thomaskneisel/LightRider/Inspiration.md

Inspiration
======

<h4>Quellen:</h4>
 * GPIO 12 LEDS - https://projects.drogon.net/raspberry-pi/gpio-examples/ladder-game/
 * GPIO & Pyton - http://www.thirdeyevis.com/pi-page-2.php
 * "NightRider" Lights - http://www.raspberrypi-spy.co.uk/2012/06/knight-rider-cylon-lights-for-the-raspberry-pi/
 * Buttons Tutorials : Pull-Up/Down placement - http://www.cl.cam.ac.uk/projects/raspberrypi/tutorials/robot/buttons_and_switches/
 * Internal Pull-Downs (1.8KOhm) - https://projects.drogon.net/raspberry-pi/gpio-examples/tux-crossing/3-more-leds-and-a-button/
  * !!Darlington Array - http://www.petervis.com/Raspberry_PI/Raspberry_Pi_GPIO_Header/Raspberry_Pi_GPIO_Header_Pin_Interfacing.html
  * OctoPrint Events: https://github.com/foosel/OctoPrint/wiki/Available-Events
  
<h4>Hilfe:</h4>
 * www.google.de :P
 * LED-Vorwiderstandsrechner - http://www.elektronik-kompendium.de/sites/bau/1109111.htm
 * LED-Rechner - http://www.spaceflakes.de/led-rechner/
 * Transistoren - http://bastelmolch.ba.funpic.de/transistor.htm
 * Elektronic Simulator - Solve Elec - http://www.physicsbox.com/indexsolveelec2en.html
 * !PCB-Bredboard layouter - http://fritzing.org/download/
  
<h4>3-D Models:</h4>
 * LED light for velleman K8200 - http://www.thingiverse.com/thing:155262
