thomaskneisel/LightRider/docs/images/Light Rider_RPi_free_Schaltplan.png

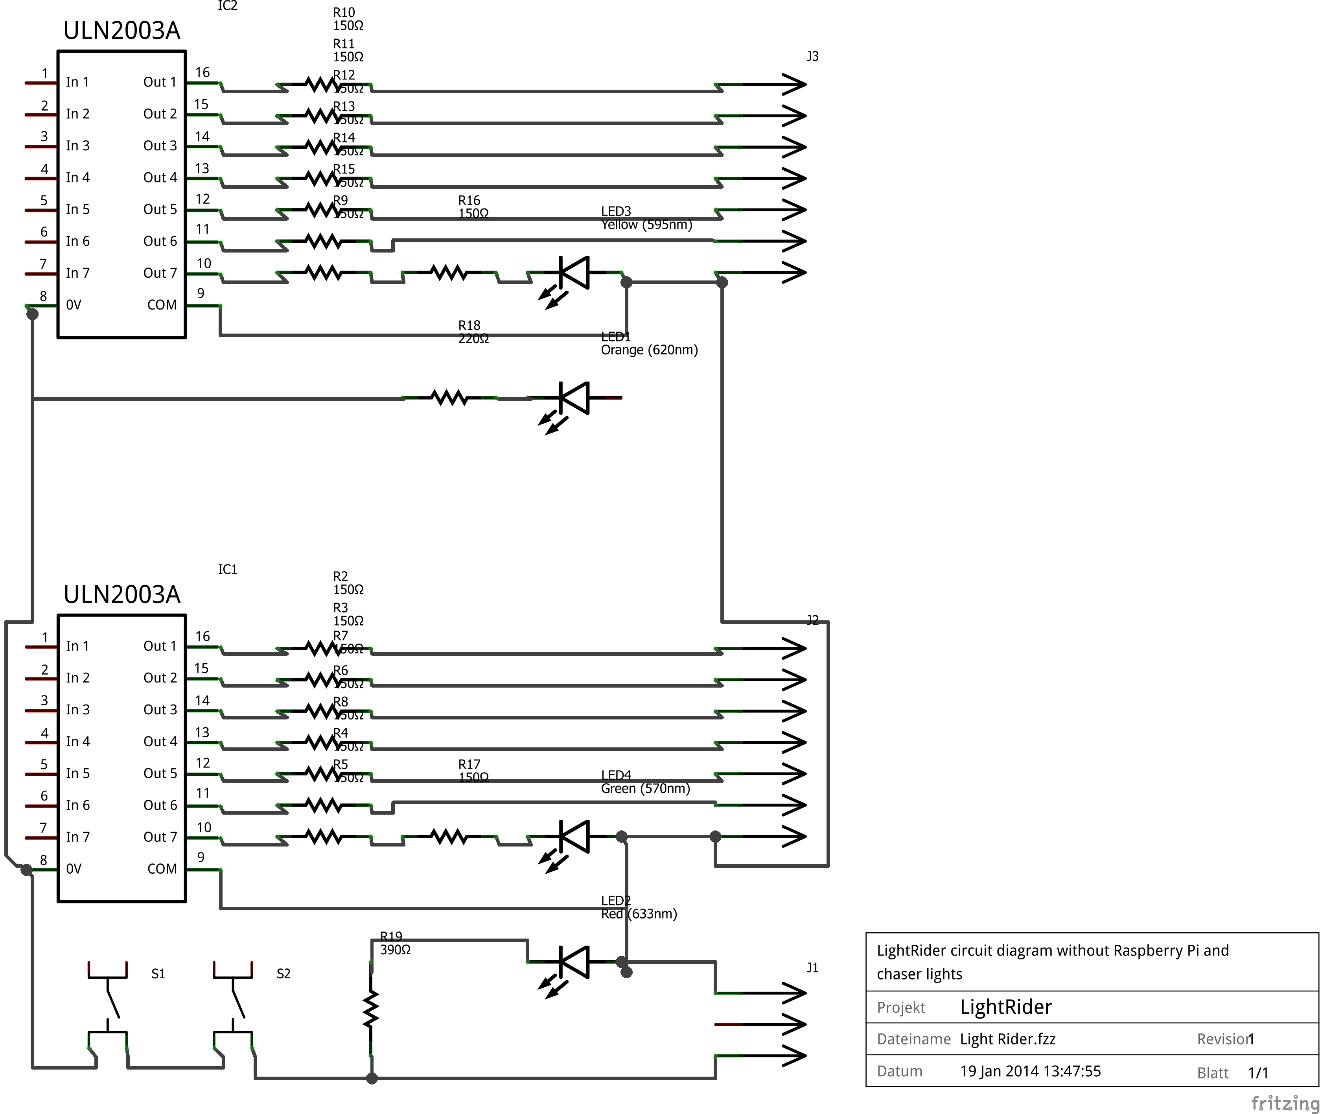
docs/images/Light Rider_RPi_free_Schaltplan.png
