thomaskneisel/LightRider/docs/images/Light Rider_Steckplatine.png

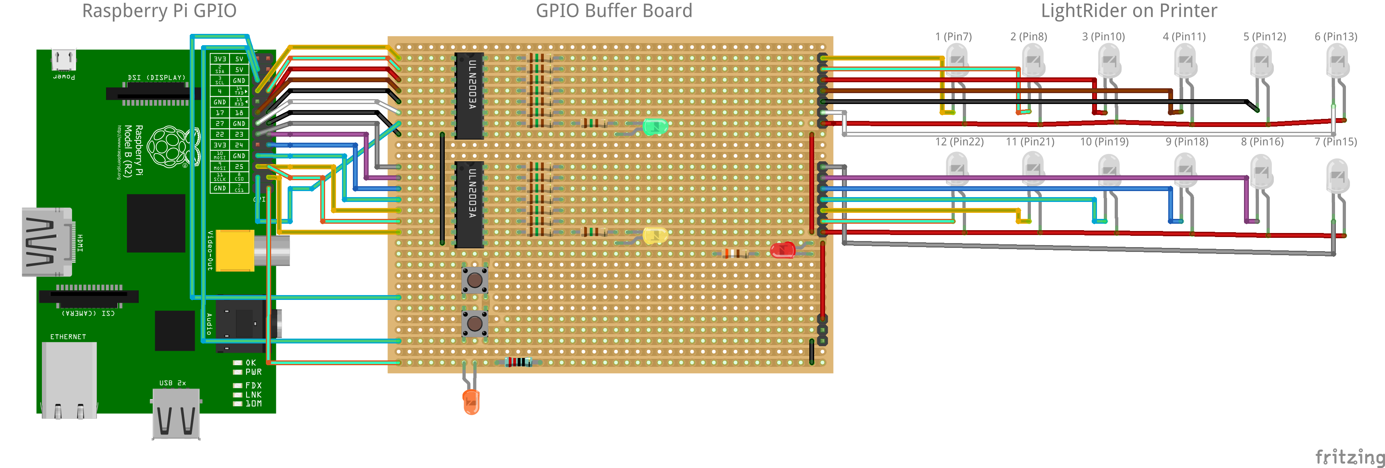
docs/images/Light Rider_Steckplatine.png
