thomaskneisel/LightRider/docs/images/LightRider_Schaltplan.png

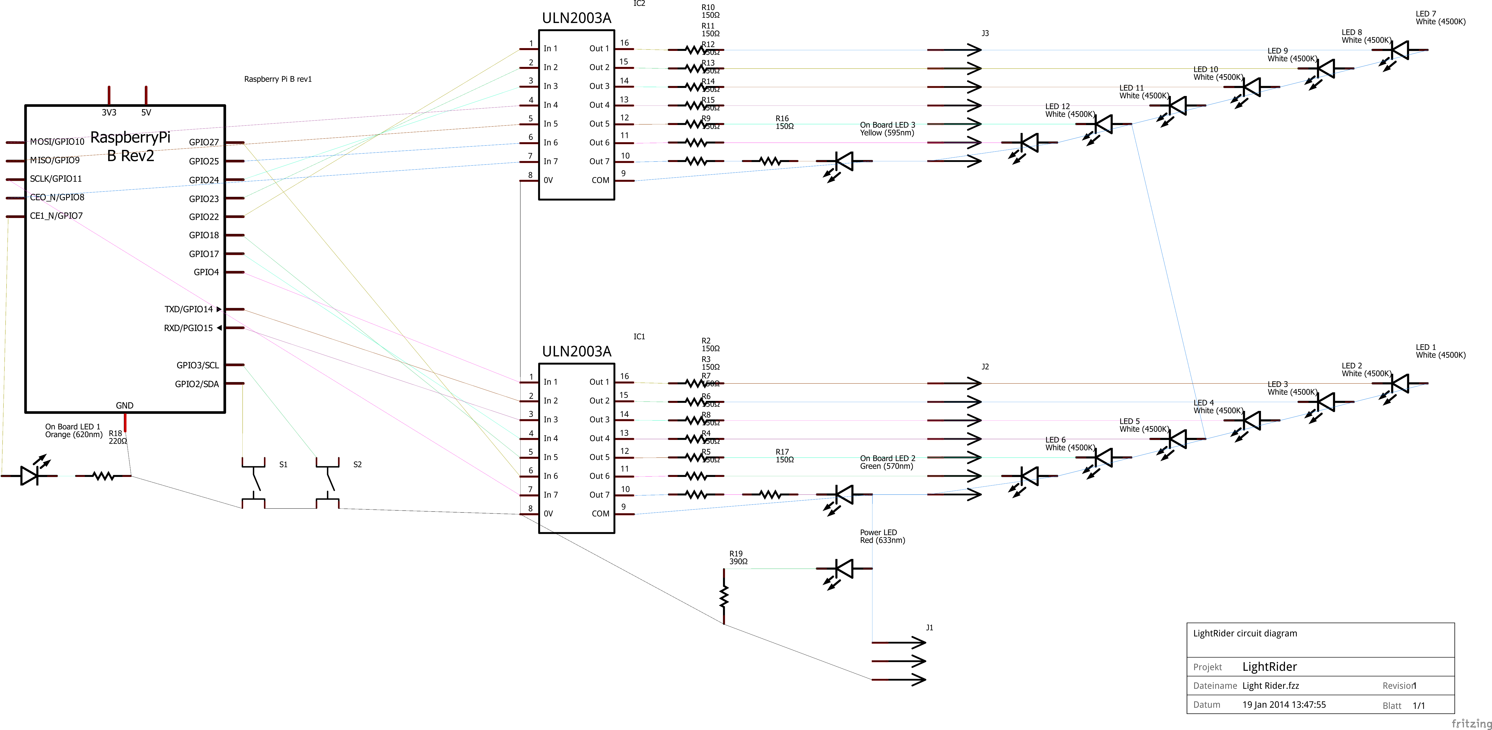
docs/images/LightRider_Schaltplan.png
