thomaskneisel/LightRider/(list of files, drawings)

Other design files:
docs/fritzing/Light Rider_RPi_free.fzz
docs/fritzing/LightRider.fzz
