thomaskneisel/LightRider/(commit log)

2014-01-20 refs #6 add hardware resources for rebuilding the prefboard
    [Case.scad, Light Rider.scad, Light Rider_RPi_free.fzz, LightRider.fzz, LightRider_Ring.scad]
2014-01-25 refs #4 #5 introduce demo mode
    add some sequences
    add some octoPrint Events
    add Standalone mode for runner
    add demo mode iterates all sequences controll with buttons
2014-01-26 add Power infos
